cyberpank00/PLCJS_ETH_MODULE_8AI_D4MG_STM32F407VGT6PLCJS/tools/README.md

# Инструменты 8AIC — калибровка и конфигурирование по Modbus TCP

Два эквивалентных клиента для настройки и калибровки модуля 8AIC
(8× 4–20 mA, АЦП `ADS1220`):

- `calibrate.mjs` — Node.js 18+, без внешних npm-пакетов
- `calibrate.py` — Python 3.8+, только стандартная библиотека

Оба реализуют встроенный Modbus TCP клиент и одинаковый диалог.

## Зачем нужна калибровка

Модуль измеряет `I_raw = code/2²³ × V_REF / R_shunt`. Допуск шунта (0.1 %),
ошибка опоры REF5020 (0.05 %) и деление 1 kΩ / входное сопротивление АЦП
(~0.05 %) снимаются поканальной линейной моделью:

```
I_true = gain × I_raw + offset        (mA)
```

Коэффициенты находятся методом наименьших квадратов по ≥ 2 точкам от
прецизионного источника/калибратора тока.

## Одноразовая запись (write-once) — читать перед калибровкой

Коэффициенты в регистрах `540 + ch×4` — **живой предпросмотр** (до
перезагрузки). Постоянное хранение — команда **COMMIT** (`HR131 = 0xCA00 | ch`),
которая программирует слот канала в отдельном секторе Flash и **блокирует его
навсегда**. Инструмент после расчёта спрашивает подтверждение — нужно набрать
слово `COMMIT`. Любой другой ответ оставляет предпросмотр без фиксации.

Разблокировать можно только аварийным стиранием всего сектора
(`HR132 = 0xC1A5` + удержание кнопки `FACT_RES`), см. README репозитория.

## Порядок калибровки одного канала

1. Подключите калибратор тока к клеммам канала (`AIn+` / `GND_ISO`).
2. Включите канал и запустите:
   ```
   node calibrate.mjs set --ch 0 --enable 1 --ip 192.168.1.13
   node calibrate.mjs calibrate --ch 0 --ip 192.168.1.13
   # или
   python calibrate.py calibrate --ch 0 --ip 192.168.1.13
   ```
3. Для каждой точки: выставьте ток на калибраторе, введите его в mA,
   инструмент усреднит `I_raw` (8 отсчётов). Наберите ≥ 2 точки
   (рекомендуется 3: **4, 12, 20 mA**), затем `done`.
4. Инструмент вычислит `gain/offset`, покажет максимальную невязку и запишет
   коэффициенты как предпросмотр.
5. Проверьте невязку; если устраивает — наберите `COMMIT`.

Пороги шкалы канала на `I_raw` не влияют. Точки ниже 3.6 mA на live-zero
шкале (нижний порог ≥ 3600 мкА) будут помечены как FAULT (обрыв) — при этом
`I_raw` остаётся корректным, пока АЦП не насыщен, и точка годится для
калибровки.

## Другие команды

```
# Статус: ток, сырой ток, пороги шкалы, int16-показание, код АЦП, флаги, блокировки
node calibrate.mjs status
python calibrate.py status

# Настроить канал
node calibrate.mjs set --ch 0 --enable 1 --lo 4000 --hi 20000 --smooth 1
python calibrate.py set --ch 1 --enable 1 --lo 0 --hi 20000     # шкала 0–20 mA

# Скорость АЦП: 0 = 20 SPS + FIR 50/60 Гц, 1 = 90 SPS, 2 = 330 SPS
node calibrate.mjs rate 0
python calibrate.py rate 1
```

Параметры по умолчанию: `--ip 192.168.1.13 --port 502 --unit 1`.
