cyberpank00/PLCJS_ETH_MODULE_8AI_D4MG_STM32F407VGT6PLCJS/DOC/ETH_MODULE_8AIC_HW1.1_FW1.3.SCH.PDF

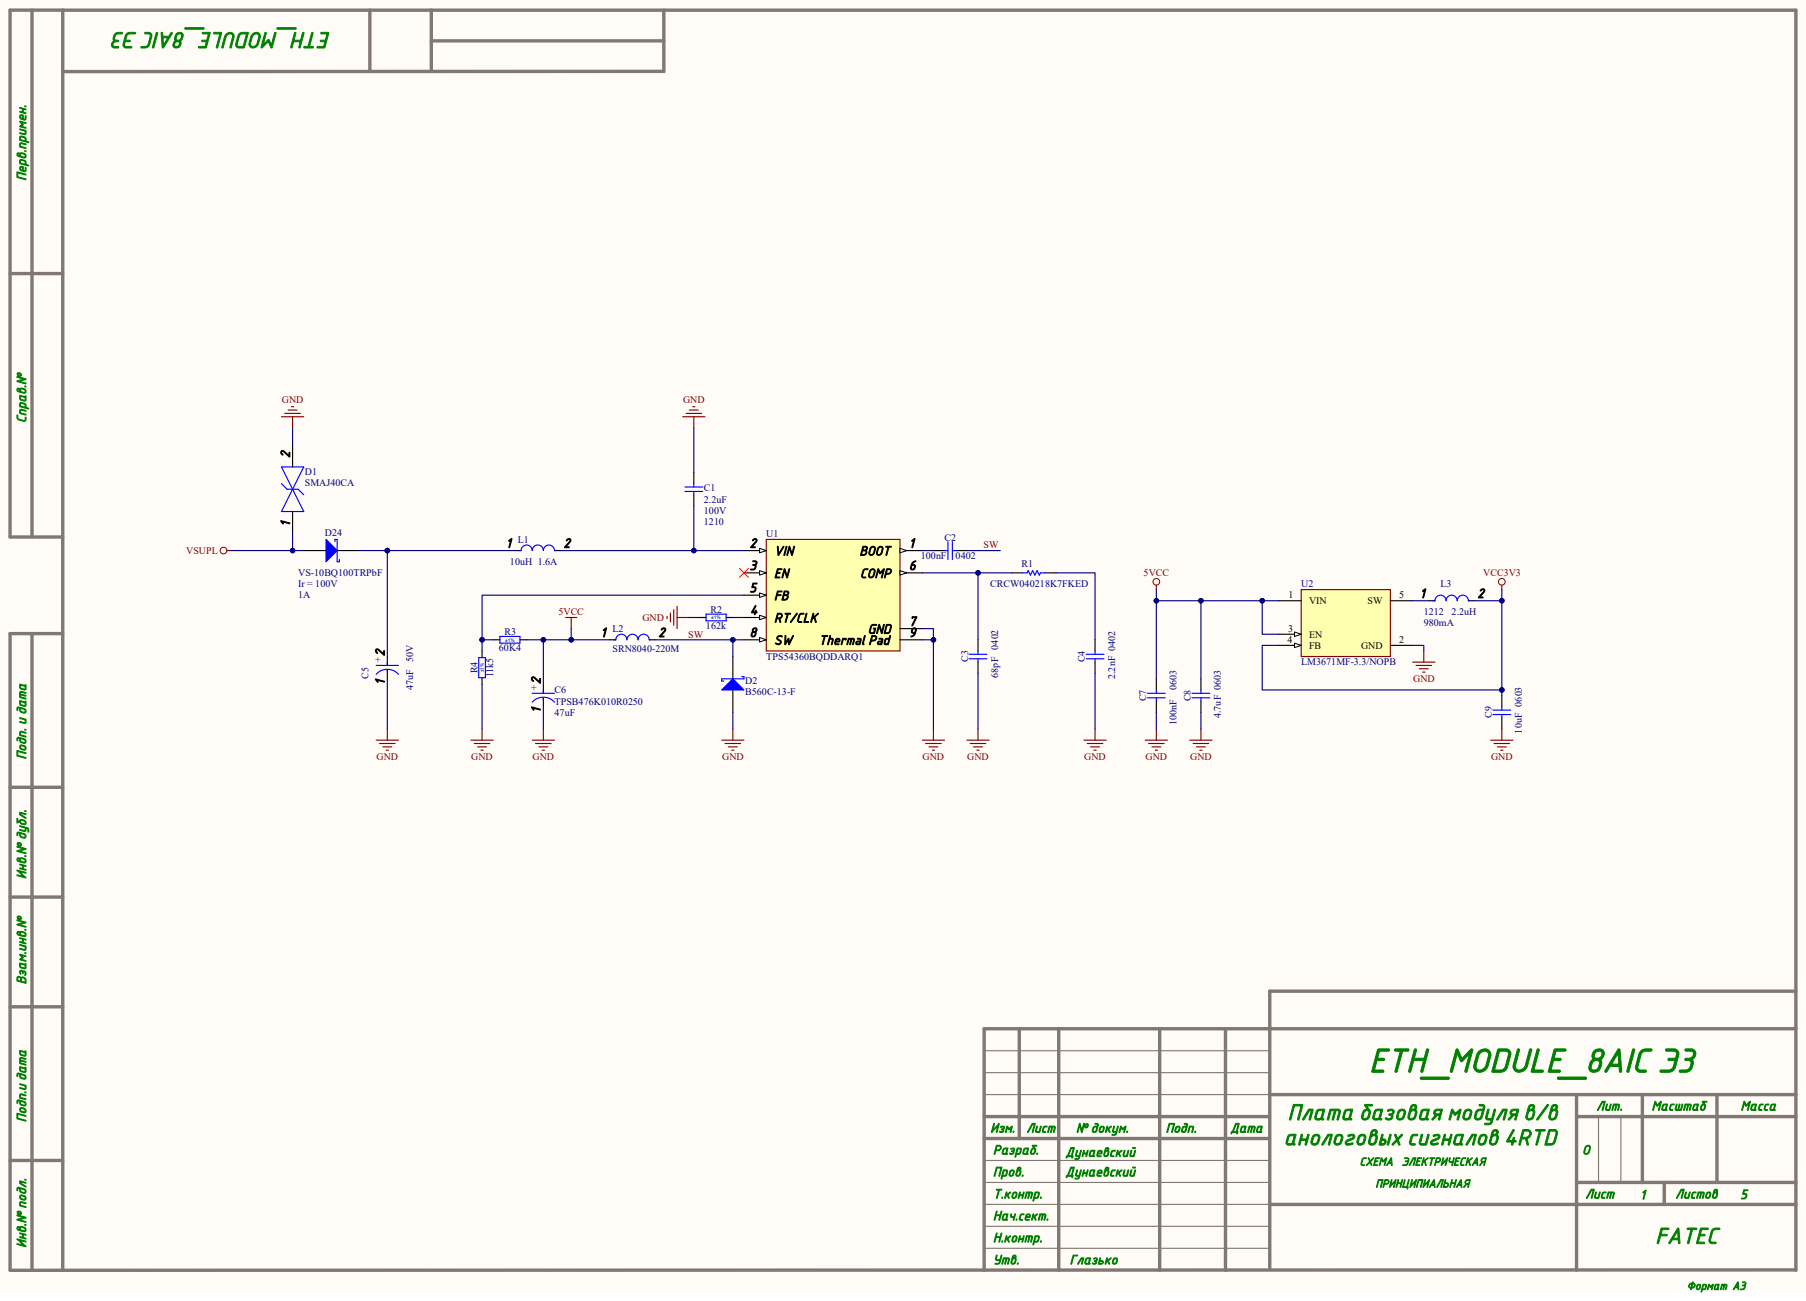
[picture p2: page 1]

Формат A3 Справ.№ Перв.примен.

Инв.№ подл. Подп.и дата Взам.инв.№ Инв.№ дубл. Подп. и дата

ETH_MODULE_8AIC Э3

Плата базовая модуля в/в анологовых сигналов 4RTD СХЕМА ЭЛЕКТРИЧЕСКАЯ ПРИНЦИПИАЛЬНАЯ | Лит. | Масштаб | Масса

Изм. | Лист | № докум. | Подп. | Дата | | О
Разраб. | | Дунаевский
Пров. | | Дунаевский
Т.контр. | | | | | Лист 1 | Листов 5
Нач.сект. | | | | | FATEC
Н.контр.
Утв. | Глазько

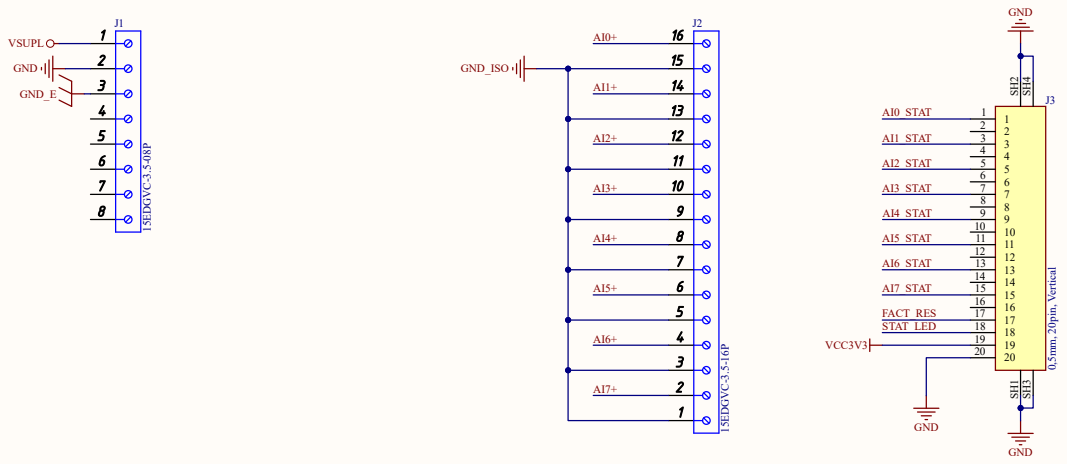
[picture p3: page 2]
Изм.; № докум.; Дата Инв.№ подл. Подп.и дата Взам.инв.№ Инв.№ дубл.; Формат A3; VSUPL; GND; VCC3V3; 15EDGVC⁻³.5⁻08P; SH¹ SH³ SH² SH⁴; J30,5mm, 20pin, Vertical; 15EDGVC⁻³.5⁻16P; STAT_LED; FACT_RES; GND_E; GND_ISO; AI0_STAT; AI1_STAT; AI2_STAT; AI3_STAT; AI4_STAT; AI5_STAT; AI6_STAT; AI7_STAT

Лист Подп. и дата

ETH_MODULE_8AIC Э3

Лист | Подп.

1 2

3

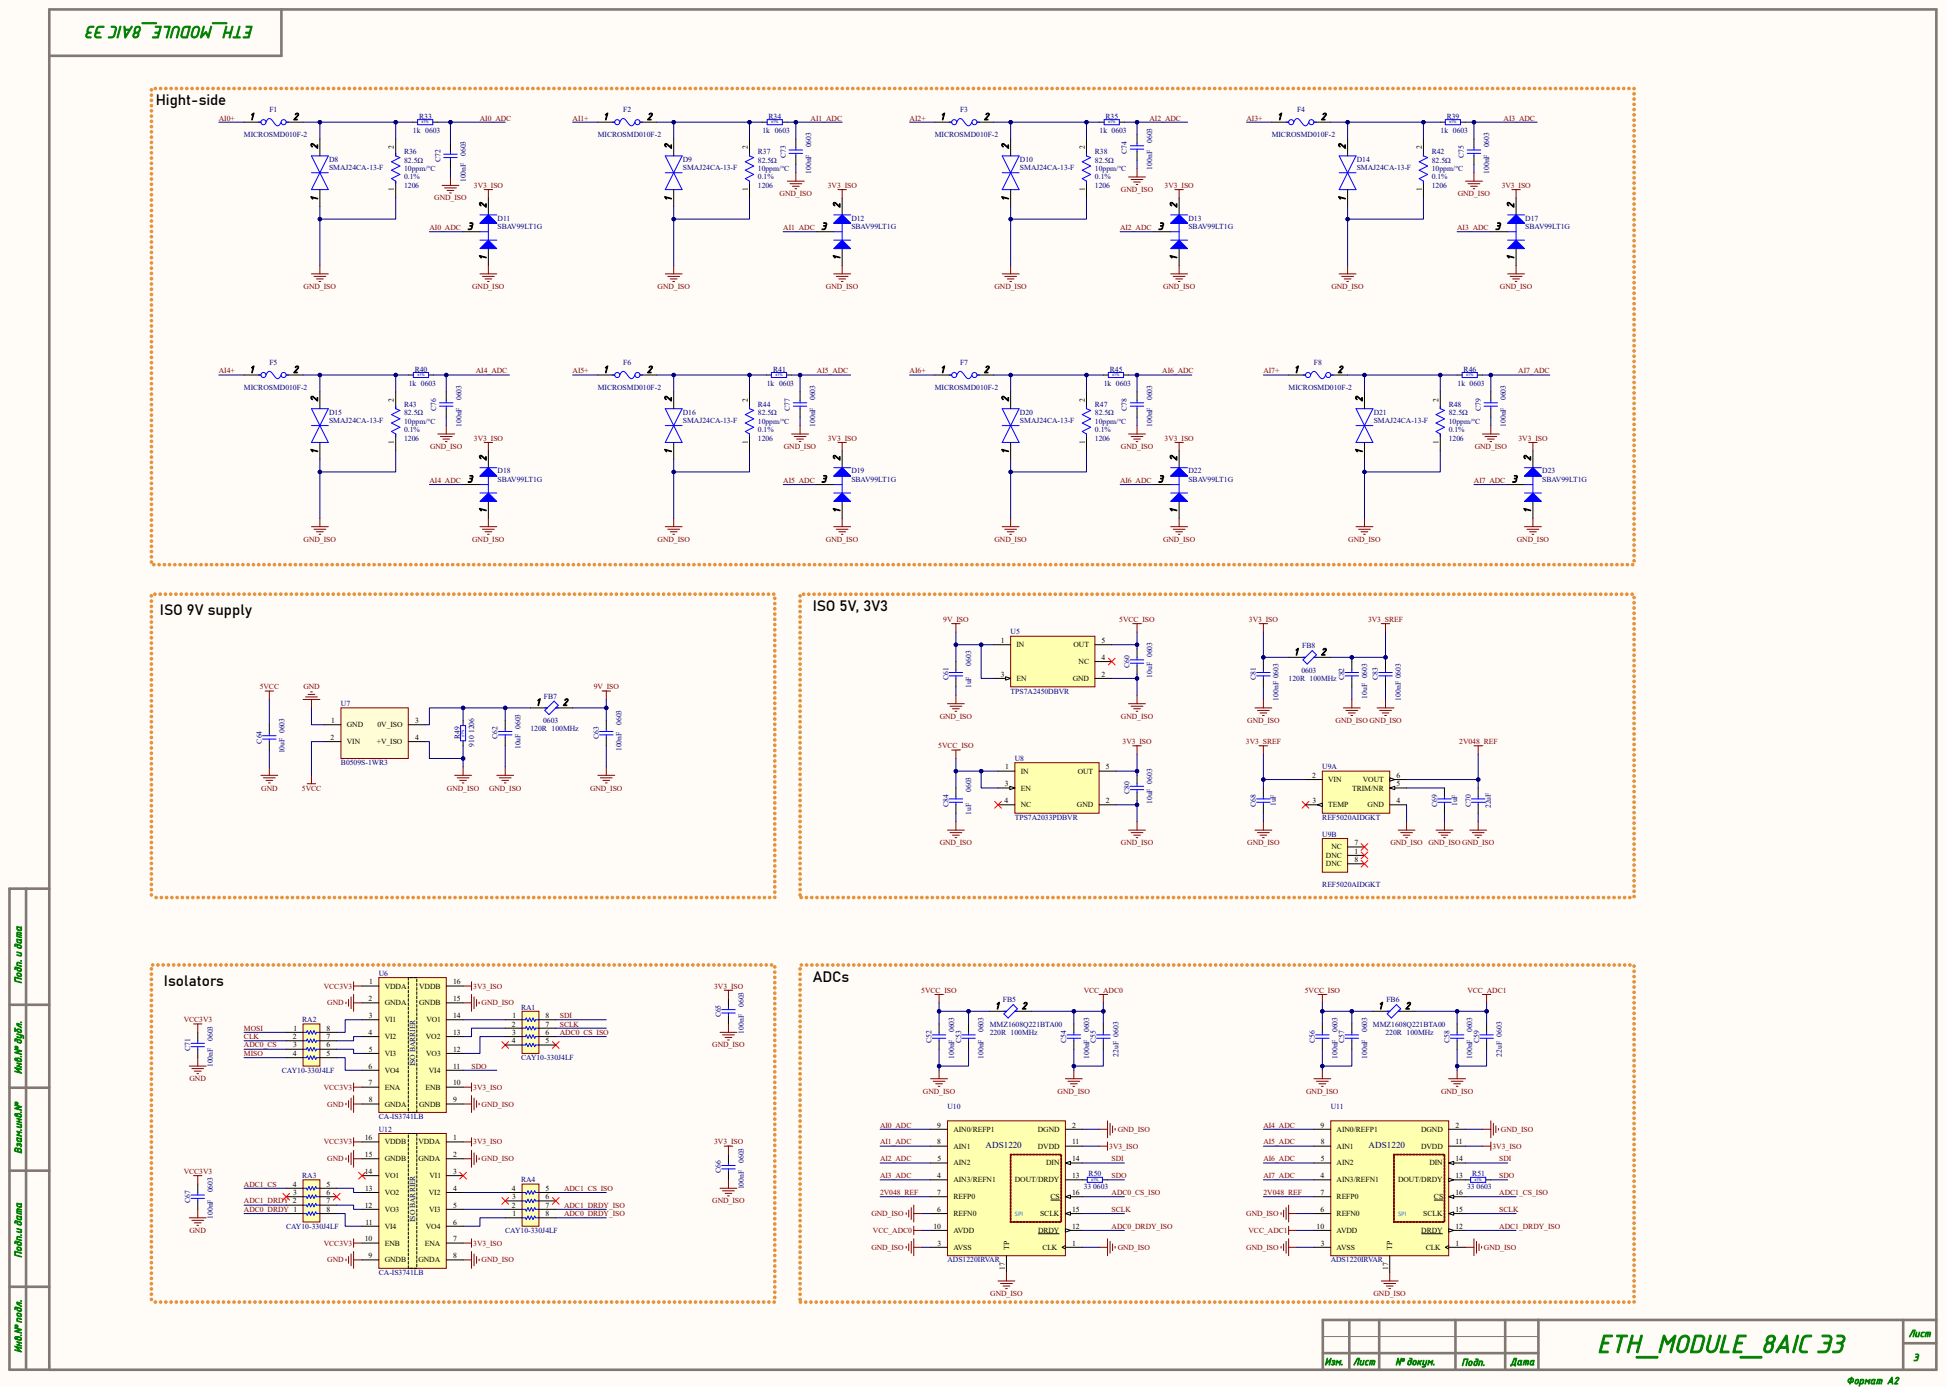
[picture p4: page 3]

Инв.№ подл. Подп.и дата Взам.инв.№ Инв.№ дубл. Подп. и дата

ETH_MODULE_8AIC Э3 | 3

Изм. | № докум. | Дата

TX+ 1
TX- 2

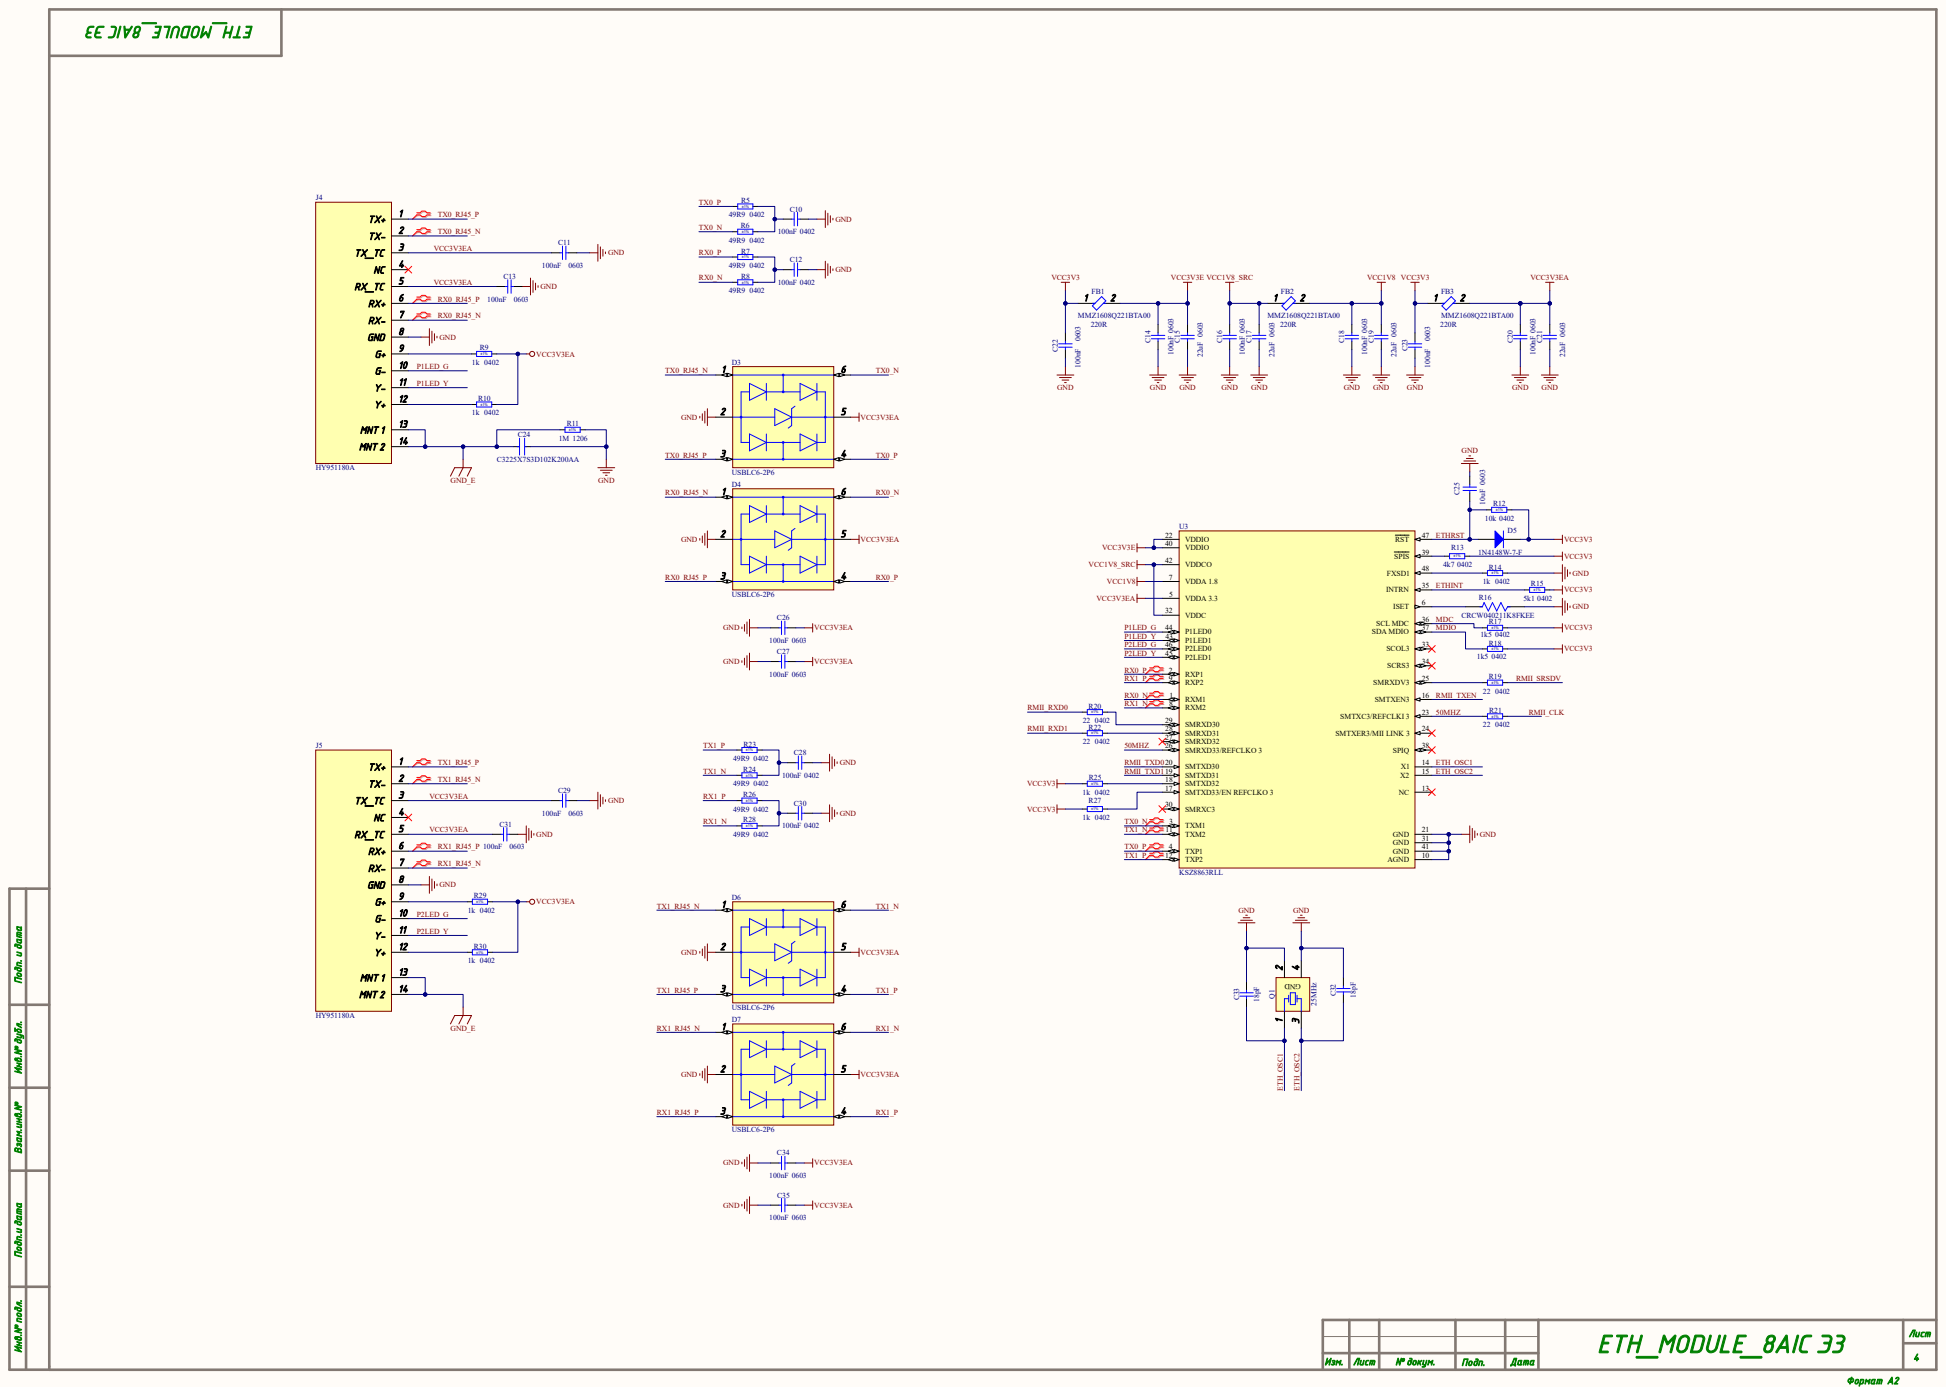
[picture p5: page 4]

Инв.№ подл. Подп.и дата Взам.инв.№ Инв.№ дубл. Подп. и дата

ETH_MODULE_8AIC Э3 | 4

Изм. | № докум. | Дата

## GND

1 2

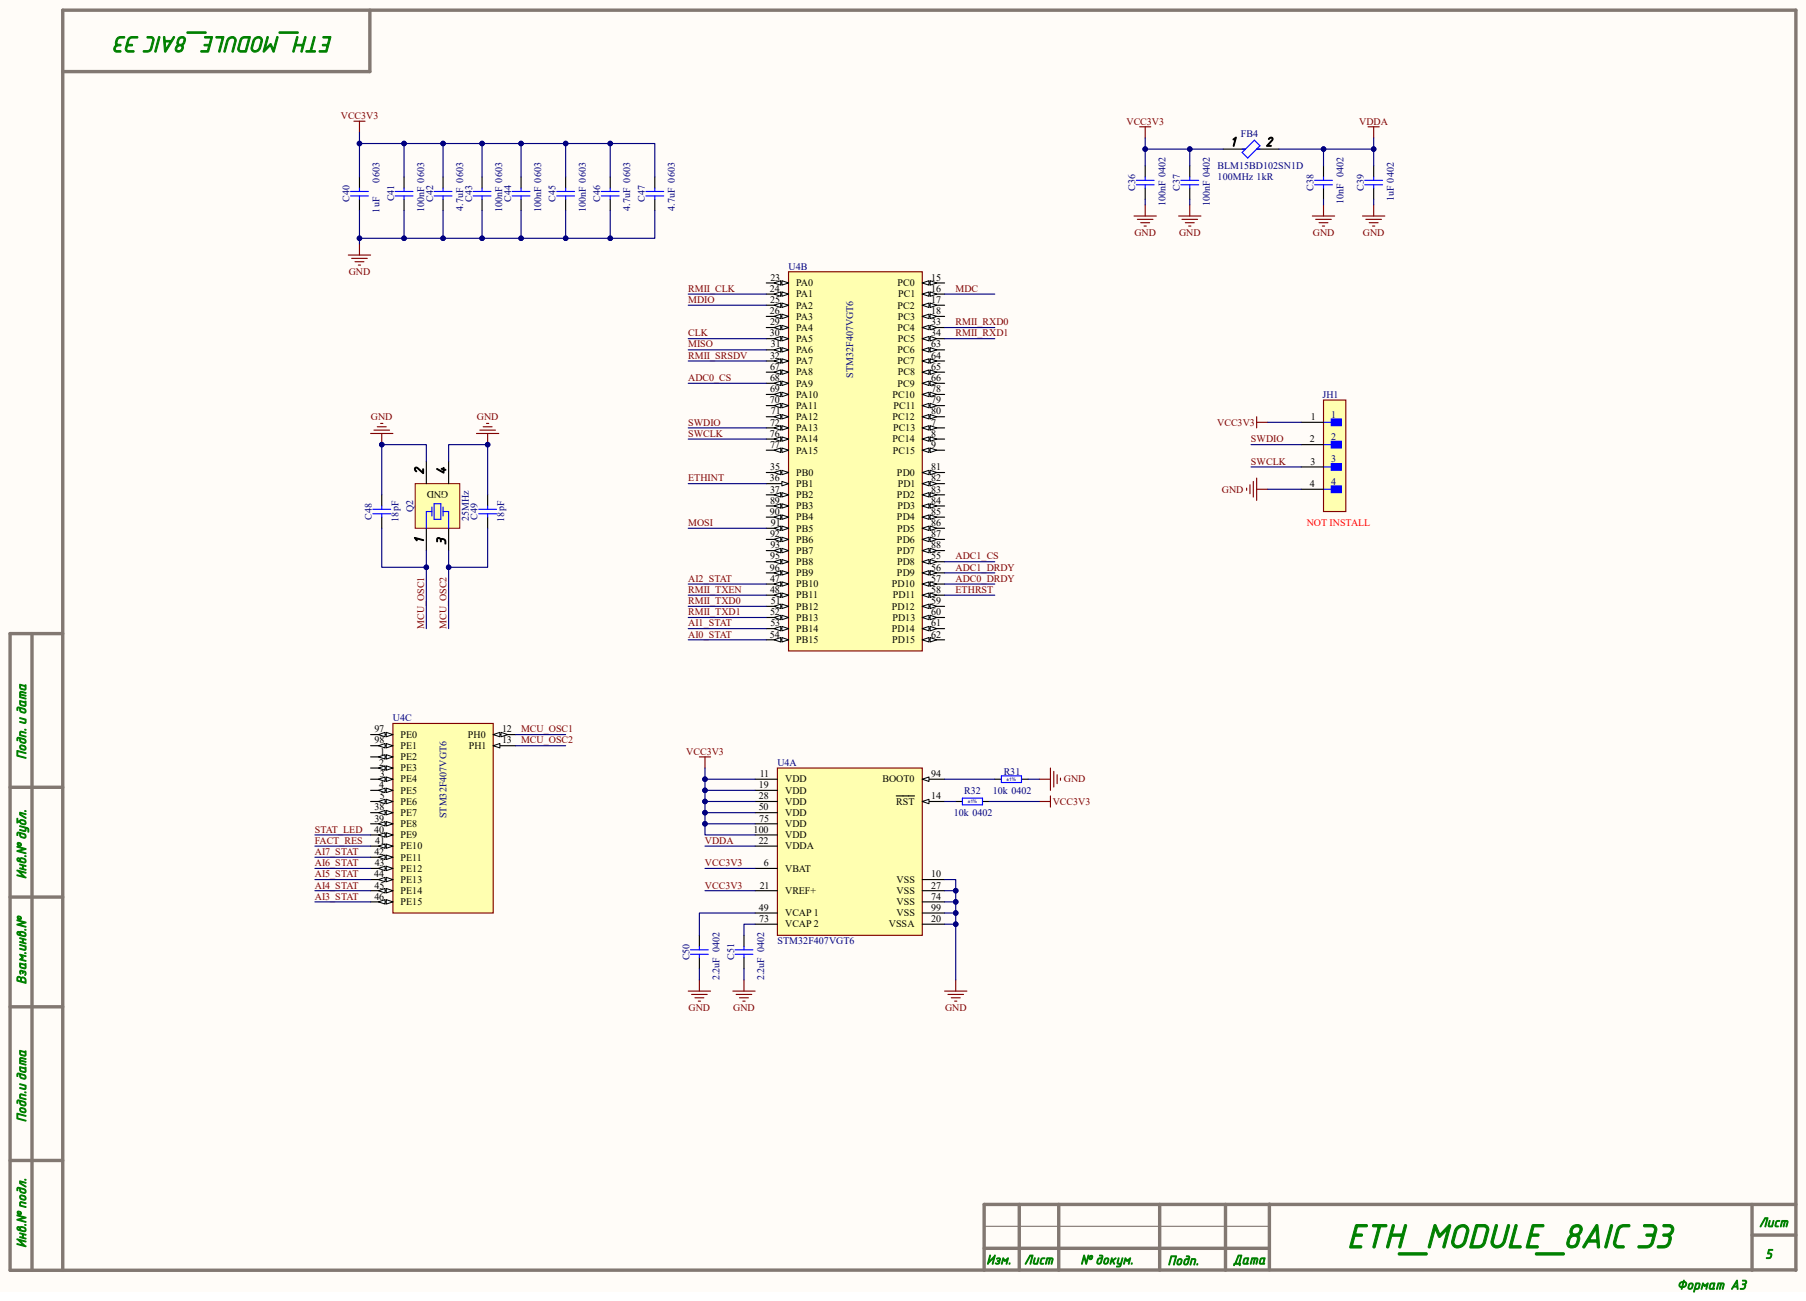
[picture p6: page 5]
