cyberpank00/PLCJS_ETH_MODULE_8AI_D4MG_STM32F407VGT6PLCJS/Core/Inc/main.h

#define ETHINT_Pin GPIO_PIN_1
#define ETHINT_GPIO_Port GPIOB
#define ETHRST_Pin GPIO_PIN_11
#define ETHRST_GPIO_Port GPIOD
#define STAT_LED_Pin GPIO_PIN_9
#define STAT_LED_GPIO_Port GPIOE
#define FACT_RES_Pin GPIO_PIN_10
#define FACT_RES_GPIO_Port GPIOE
#define ADC0_CS_Pin         GPIO_PIN_9
#define ADC0_CS_GPIO_Port   GPIOA
#define ADC1_CS_Pin         GPIO_PIN_8
#define ADC1_CS_GPIO_Port   GPIOD
#define ADC0_DRDY_Pin       GPIO_PIN_10
#define ADC0_DRDY_GPIO_Port GPIOD
#define ADC1_DRDY_Pin       GPIO_PIN_9
#define ADC1_DRDY_GPIO_Port GPIOD
#define AI0_STAT_Pin        GPIO_PIN_15
#define AI0_STAT_GPIO_Port  GPIOB
#define AI1_STAT_Pin        GPIO_PIN_14
#define AI1_STAT_GPIO_Port  GPIOB
#define AI2_STAT_Pin        GPIO_PIN_10
#define AI2_STAT_GPIO_Port  GPIOB
#define AI3_STAT_Pin        GPIO_PIN_15
#define AI3_STAT_GPIO_Port  GPIOE
#define AI4_STAT_Pin        GPIO_PIN_14
#define AI4_STAT_GPIO_Port  GPIOE
#define AI5_STAT_Pin        GPIO_PIN_13
#define AI5_STAT_GPIO_Port  GPIOE
#define AI6_STAT_Pin        GPIO_PIN_12
#define AI6_STAT_GPIO_Port  GPIOE
#define AI7_STAT_Pin        GPIO_PIN_11
#define AI7_STAT_GPIO_Port  GPIOE
