cyberpank00/PLCJS_ETH_MODULE_8AI_D4MG_STM32F407VGT6PLCJS/(commit log)

2026-09-07 8AIC: initial firmware — 8x 4-20 mA inputs on two ADS1220; fw 1.0
    Derived from the 4RTD HW2.1 firmware (fw 2.0). Identity 0x504C0804,
    IR125 module id 0x08AC, hw 1.1, SETTINGS_MAGIC 0x08AC4A57 v1.
    - Pins: ADC0_CS PC9, ADC1_CS PD9, ADC0_DRDY PD0, ADC1_DRDY PD2, channel
    LEDs PB15/PB14/PB9/PE15..PE11, STAT_LED PE9, FACT_RES PE10, ETHINT PB0.
    - ads1220/: two chips, single-ended AINx/AVSS with PGA bypass, external
    REF5020 2.048 V, single-shot per mux input synchronised on DRDY, both
    chips converted in parallel; data rate 20 SPS+FIR / 90 / 330 SPS (HR133).
    - aic/: I = code/2^23 * VREF/R_shunt (nominal 89.9 Ohm), per-channel
    write-once calibration (8 slots), fixed NAMUR-style thresholds (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
    [PLCJS_ETH_MODULE_8AIC_D4MG_STM32F407VGT6.ioc, ads1220.c, ads1220.h, aic_module.c, aic_module.h, app.c, app.h, button_module.c]
2026-09-07 8AIC: pinout per designer — ADC0_CS PC10, DRDY PD1/PD3, AI2_STAT PB10, ETHINT PB1; fw 1.1
    Generated with [Devin](https://devin.ai)
2026-09-07 8AIC: per-channel scale thresholds replace percent/range registers; fw 1.2
    Compact block: 0..7 int16 reading now auto-scales 0..32767 onto the
    channel's [low, high] thresholds; 8..15 low threshold uA (default 4000),
    16..23 high threshold uA (default 20000), 24..31 enabled (default 1),
    32..39 smoothing. The percent-of-scale group and the 4-20/0-20 selector are
    gone. Open-loop fault applies only when the low threshold is >= 3.6 mA.
    Thresholds are cross-validated on write (lo < hi <= 25000 uA).
    SETTINGS_VERSION 2. Docs and tools (--lo/--hi) updated.
    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
    [aic_module.c, aic_module.h, modbus_app.c, modbus_app.h, settings.c, settings.h]
2026-09-09 8AIC: production pinout — ADC0_CS PA9, ADC1_CS PD8, ADC0_DRDY PD10, ADC1_DRDY PD9; fw 1.3
    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
2026-09-09 docs: DOC/ — production schematic HW1.1 (fw 1.3 pinout), drop the pre-production one
    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
    [ETH_MODULE_8AIC_HW1.1_FW1.3.SCH]
2026-09-09 docs: give the production schematic its .PDF extension
    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
2026-09-09 Modbus TCP: serve up to 4 clients concurrently; fw 1.4
    modbus_tcp_server.c now keeps 4 client slots, each with its own nanoMODBUS
    context and buffers, polled round-robin from the single server task with a
    2 ms first-byte timeout so idle connections never delay a busy one. A new
    connection takes a free slot; only when all four are busy does it evict the
    longest-silent client (newest-wins). Silent clients still drop after 30 s,
    TCP keep-alive and link-down handling unchanged. lwipopts: MEMP_NUM_NETCONN /
    NETBUF / TCP_PCB raised to 8.
    Verified on 12DI hardware: 4 pollers x 15 s, ~20k requests each, 0 errors,
    p50 0.7 ms / max 16 ms; a 5th connection evicts exactly the silent slot.
    Generated wi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
    [modbus_tcp_server.c, modbus_tcp_server.h]
2026-09-10 docs: add 8AIC board photo (DOC/MAIN_BOARD.png) and show it at the top of the READMEs
    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
2026-09-10 docs: correct board hardware version in README (HW1.1 → HW1.0), reduce photo width to 500px
